ktviy/SafeRoute_Smart_Cane/README.md

<div align="center">

# SafeRoute Smart Cane

**A clip-on pod that gives a standard white cane a one-step warning for drop-offs and head-level obstacles, delivered as haptic rhythm.**







[**Live Dashboard**](https://ktviy.github.io/SafeRoute_Smart_Cane/dashboard/) ·
[**Data Report (PDF)**](docs/SafeRoute_DATA_REPORT.pdf) ·
[**Schematic**](hardware/schematic.svg) ·
[**CAD Design**](CAD_Design) ·
[**Firmware Guide**](firmware/README.md) ·
[**Experiment Results**](experiment_data/results/report.md)

</div>

<details>
<summary><b>Table of Contents</b></summary>

1. [About the Project](#about-the-project)
2. [Key Results](#key-results)
3. [How It Works](#how-it-works)
4. [Hardware](#hardware)
5. [Getting Started](#getting-started)
6. [Usage](#usage)
7. [Experiment Data](#experiment-data)
8. [Repository Structure](#repository-structure)
9. [Roadmap](#roadmap)
10. [Team](#team)
11. [Acknowledgments](#acknowledgments)
12. [License](#license)

</details>

---

## About the Project

A white cane is excellent at reading what is directly under its tip, but it misses two kinds of hazard that matter for low-vision travellers:

| Hazard | Examples | Why the cane misses it |
| --- | --- | --- |
| **Drop-offs** | Curbs, stair tops, platform edges | The tip finds the edge at nearly the same moment the user reaches it, leaving little time to react. |
| **Head-level obstacles** | Signs, branches, open truck doors | The cane sweeps the ground and passes underneath them. |

**SafeRoute** is a small pod that clips onto an existing cane. Two time-of-flight beams look ahead of the tip and up to head height. When a real hazard appears, two vibration motors send a distinct rhythm up the shaft to the hand. A three-rule filter keeps the pod **silent during normal sweeping**, so every buzz means something.

**Design principles**

- **Augment, don't replace.** The user keeps their cane and their training; the pod only adds information.
- **Alert only on hazards.** Constant feedback causes fatigue and gets ignored. The pod stays quiet unless a confirmed hazard is inside the walking corridor.
- **Every number from real data.** All thresholds and mounting angles come from 18 recordings of a real cane user. Nothing in this repository is simulated.

<p align="right">(<a href="#readme-top">back to top</a>)</p>

## Key Results

Measured on real cane recordings (walker P1, 30 Oct – 3 Nov 2026). Full method and data in the [DATA REPORT](docs/SafeRoute_DATA_REPORT.pdf).

| Metric | Result |
| --- | --- |
| Look-ahead past the cane tip | **~0.76 m** |
| Warning time at walking speed (0.78–0.84 m/s) | **0.79–0.86 s** |
| Frames a 30 cm drop stays in the beam (fastest sweep) | **3.9 frames** at 30 Hz, so 3-frame confirmation **passes** |
| Firmware angle error while walking (p95) | **2.4–3.4°** (≈ 1 cm drop-height error per degree; alert threshold is 8 cm) |
| Cane angle while walking | 41.1° (36.5–45.1°) on 120 cm cane → **36.9°** on the 130 cm build |
| Sweep frequency / half-width (p95) | 0.45–0.49 Hz / 23–24° |
| Cane angle after finding an edge | 63–84° peak, past 57° within 0.6–0.9 s |
| Stair descent rhythm | 1.47 s per step |

<p align="right">(<a href="#readme-top">back to top</a>)</p>

## How It Works

```mermaid
flowchart LR
    A["Ground ToF<br/>(19° above shaft)"] --> D["Drop height dh"]
    B["Forward ToF<br/>(73° above shaft)"] --> E["Obstacle height H"]
    C["MPU-6050 IMU"] --> F["Cane angle +<br/>sweep position"]
    F --> D
    F --> E
    D --> G{"3-rule filter<br/>confirm · band · corridor"}
    E --> G
    G -->|"drop-off"| H["3 fast strong pulses<br/>both motors"]
    G -->|"head level"| I["2 medium pulses<br/>on that side"]
    G -->|"normal sweep"| J["Silent"]
```

1. **Sensing.** The **ground beam** hits the floor about 0.76 m past the tip. Combined with the cane angle, it gives the floor height ahead (`dh`); a drop deeper than **8 cm** is a drop-off. The **forward beam** measures how high an obstacle in front is.
2. **Sweep tracking.** The MPU-6050 IMU gives the cane angle and the position within the sweep. The user holds a trained **38°** angle and sweeps **±23°**, both taken from the recordings.
3. **Filtering.** An alert must pass three rules:
   - **Confirmation:** seen in 3 consecutive frames (2 for head level).
   - **Height band:** the measured height falls in the hazard's band.
   - **Corridor:** the hazard is in the walking path, not beside it.

   When the cane is lifted above **52°** (the user has already found the edge), the pod goes quiet.
4. **Haptics.** Each hazard has its own rhythm, so the user can tell them apart without thinking.

The decision logic is plain, hardware-free C++ in [`firmware/lib/saferoute`](firmware/lib/saferoute), so it runs and is unit-tested on a laptop. The equations are in the [firmware guide](firmware/README.md#how-the-logic-works).

<p align="right">(<a href="#readme-top">back to top</a>)</p>

## Hardware

| Component | Role |
| --- | --- |
| ESP32-DevKitC | Controller, USB and BLE telemetry |
| 2 × VL53L1X time-of-flight sensors | Ground beam (19°, drop-offs) and forward beam (73°, head level) |
| MPU-6050 6-axis IMU | Cane angle and sweep position |
| 2 × DRV2605L + ERM motor discs | Left / right haptic rhythm |
| RGB LED, push button, USB power bank | Status, on / off, 5 V supply |

<p align="center">
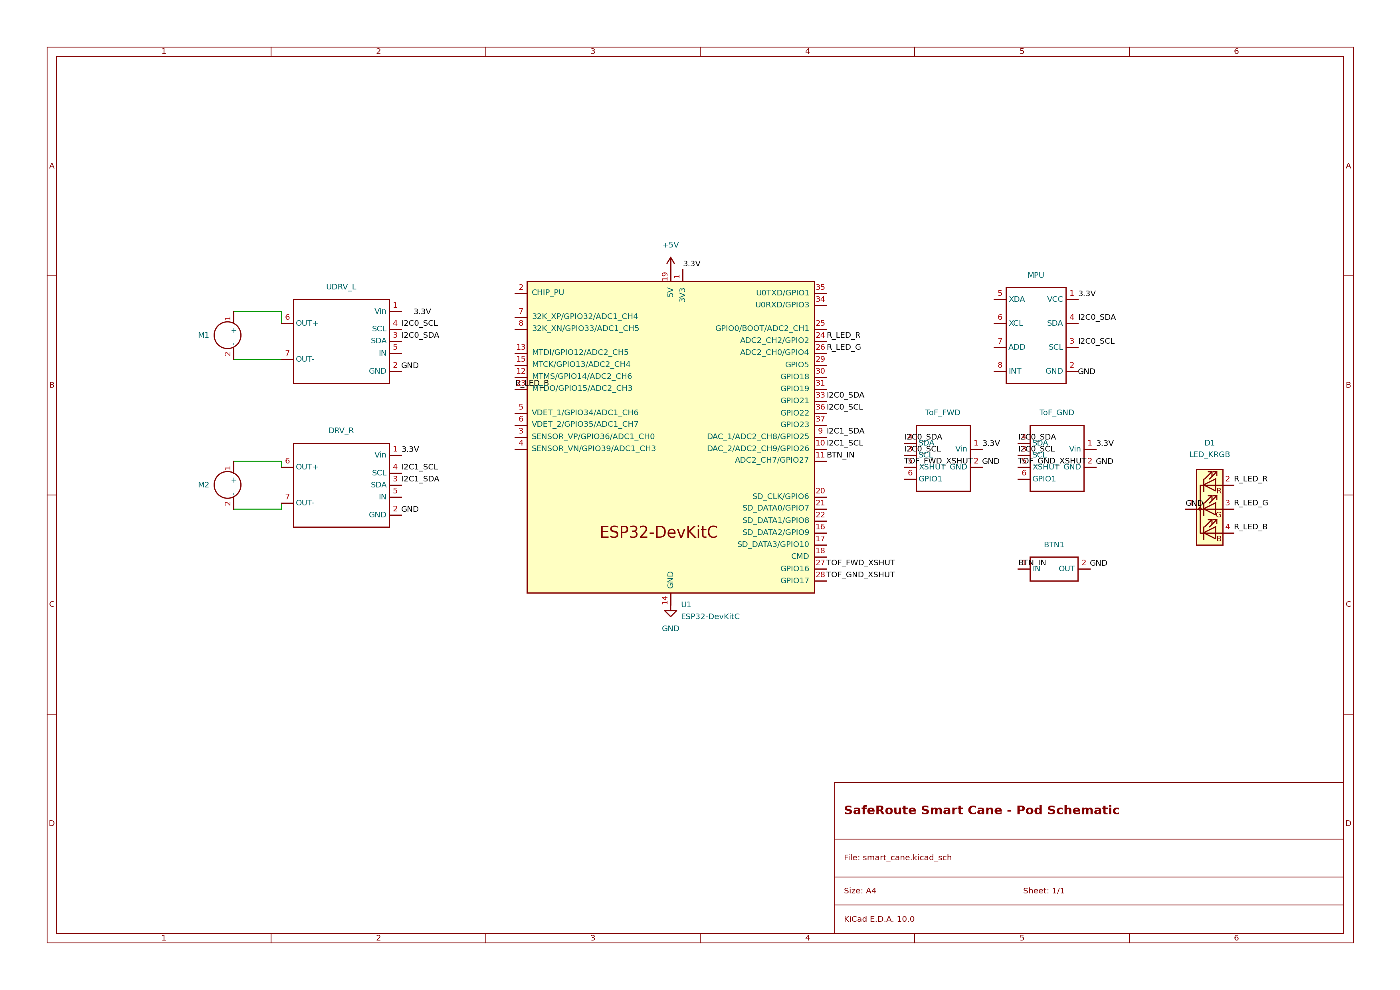
[picture p1: hardware/schematic.png]
SafeRoute schematic
  
</p>

**→ [`hardware/`](hardware):** full BOM with references, pin map, design notes and the KiCad project.

### Mechanical Design

The 130 cm cane is printed in six segments that join with spigot-and-socket fittings, and the pod attaches with a printed clip 0.72 m from the tip.

<p align="center">
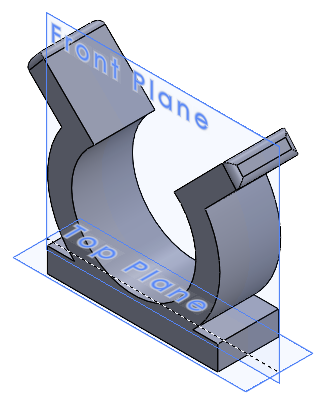
[picture p2: CAD_Design/images/HackathonClipping.png]
  
  &nbsp;&nbsp;
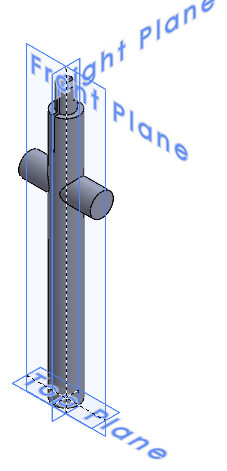
[picture p3: CAD_Design/images/HackathonStaff4.png]
  
  &nbsp;&nbsp;
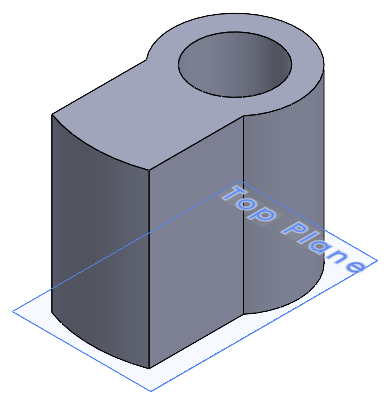
[picture p4: CAD_Design/images/UnbalancedMass.png]
  
</p>

**→ [`CAD_Design/`](CAD_Design):** SolidWorks parts, assembly order and print notes.

<p align="right">(<a href="#readme-top">back to top</a>)</p>

## Getting Started

### Prerequisites

- [PlatformIO](https://platformio.org/) (VS Code extension or `pip install platformio`)
- `gcc` on your PATH for the native unit tests
- Python 3.9+ for the experiment analysis
- Chrome or Edge for the web dashboard (Web Serial / Web Bluetooth)

### Build and Flash the Firmware

```bash
git clone https://github.com/ktviy/SafeRoute_Smart_Cane.git
cd SafeRoute_Smart_Cane/firmware

pio test -e native              # run the 45 unit tests on your laptop
pio run -e esp32dev -t upload   # build and flash the pod
pio device monitor              # 460800 baud, type 'help'
```

> [!TIP]
> On Windows, run `pio` from PowerShell. If upload hangs at `Connecting...`, hold **BOOT**, tap **EN**, and release BOOT when writing starts. More fixes are in the [troubleshooting table](firmware/README.md#build-flash-test).

### Reproduce the Analysis

```bash
cd experiment_data
pip install numpy pandas matplotlib
python analyze_cane.py analyze  # rebuilds results/ and results/plots/
```

<p align="right">(<a href="#readme-top">back to top</a>)</p>

## Usage

### Controls

| Action | Result |
| --- | --- |
| Power on | Pod starts **OFF** (lasers held off, low current) |
| **Click** | Pod turns **ON**: lasers start, one left-then-right ring, LED on |
| **Double click** | Pod turns **OFF** |

### Haptic Language

| Pattern | Meaning |
| --- | --- |
| 3 fast strong pulses, both motors | Drop-off ahead |
| 4 rapid strong pulses | Drop-off ahead, little time left |
| 2 medium pulses on one side | Head-level obstacle on that side |

Status and fault patterns are listed in the [firmware guide](firmware/README.md#using-the-pod).

### Live Dashboard

Open the [**live dashboard**](https://ktviy.github.io/SafeRoute_Smart_Cane/dashboard/) in Chrome or Edge, power the pod, then press **USB** or **Bluetooth**. Details and the Python version: [`dashboard/`](dashboard).

<p align="right">(<a href="#readme-top">back to top</a>)</p>

## Experiment Data

Every design number comes from **18 real recordings** of a white-cane user (phone IMU at 100 Hz on the cane): walking with constant-contact and two-point technique, curbs, stair tops, stair descents, objects beside the path and timed walks.

| Walking, constant contact | Stair top found |
| :---: | :---: |
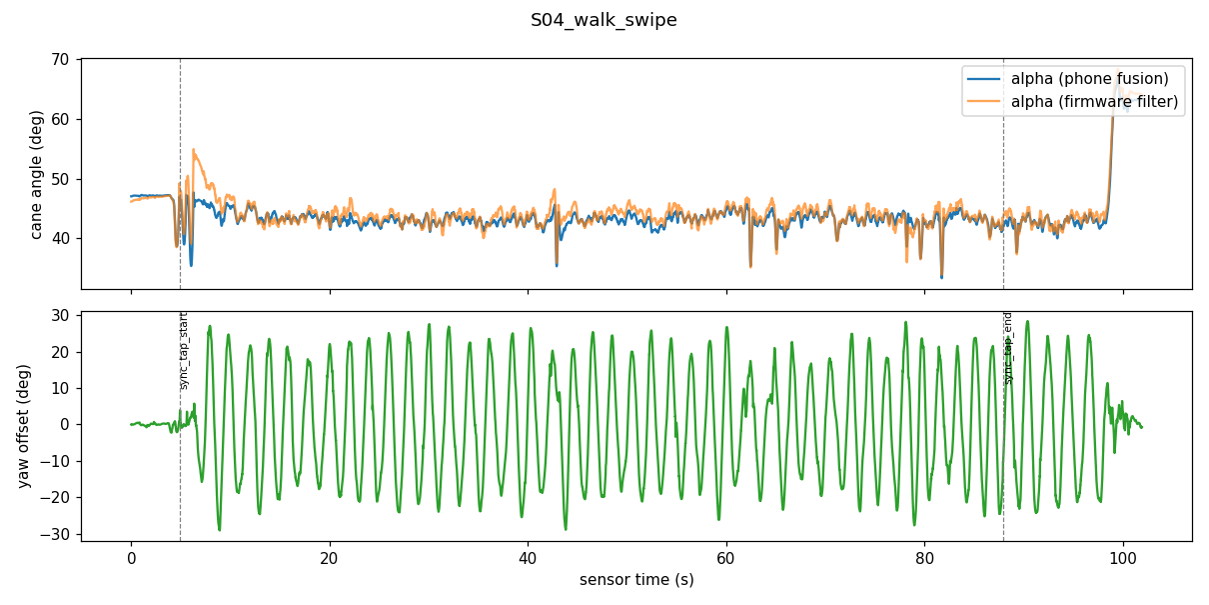
[picture p5: experiment_data/results/plots/S04_walk_swipe.png]
S04
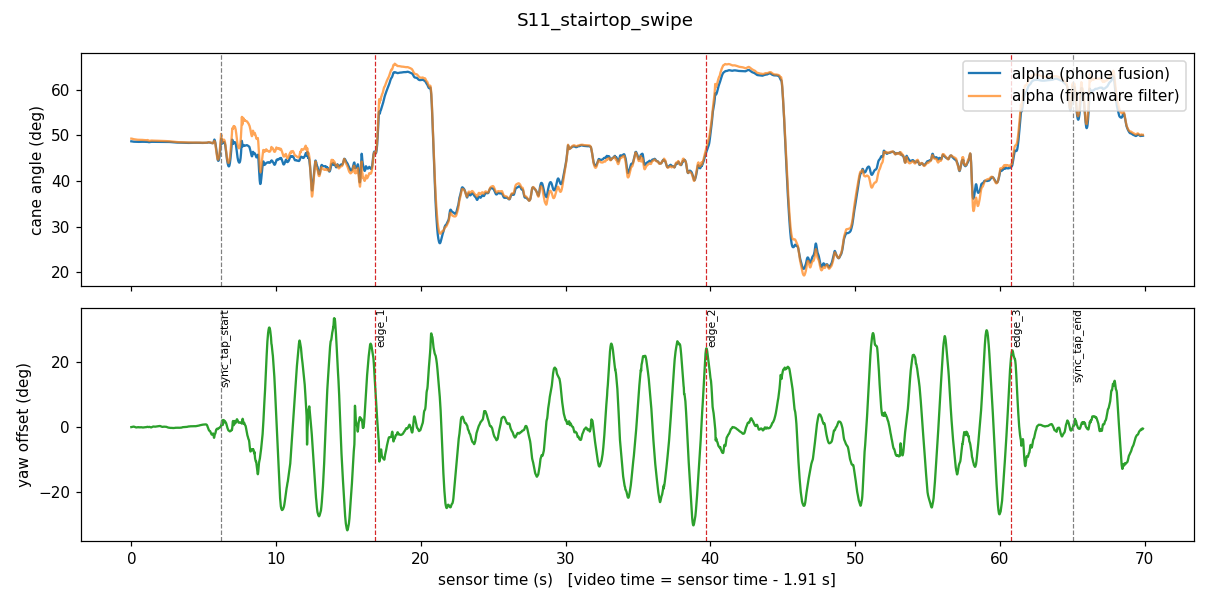
[picture p6: experiment_data/results/plots/S11_stairtop_swipe.png]
S11
|  |  |

**→ [`experiment_data/`](experiment_data):** raw data, analysis scripts, all 17 plots and the [results report](experiment_data/results/report.md).

<p align="right">(<a href="#readme-top">back to top</a>)</p>

## Repository Structure

```
SafeRoute_Smart_Cane/
├── firmware/            ESP32 firmware (PlatformIO)
│   ├── include/config.h     every tunable number and pin
│   ├── lib/saferoute/       hardware-free pod logic (kinematics, filter, haptics, ...)
│   ├── src/                 ESP32 main loop, HAL drivers, BLE telemetry
│   └── test/                45 native unit tests
├── hardware/            KiCad schematic project + SVG/PNG export
├── CAD_Design/          SolidWorks parts (cane segments, pod clip, motor mass) + preview images
├── experiment_data/     raw cane recordings, analysis scripts, results and plots
├── dashboard/           web dashboard (Web Serial / Web Bluetooth) + Python version
└── docs/                DATA REPORT: every design number and its source
```

<p align="right">(<a href="#readme-top">back to top</a>)</p>

## Roadmap

- [x] Clip-on pod with dual ToF beams and dual haptic motors
- [x] IMU-based cane angle and sweep tracking
- [x] Three-rule alert filter with edge-found pause
- [x] Live web dashboard over USB and Bluetooth
- [x] Design numbers derived from 18 real cane recordings
- [ ] Verify the cane angle statically on the 130 cm build cane
- [ ] Test with more walkers and orientation & mobility instructors
- [ ] Custom PCB and smaller enclosure

<p align="right">(<a href="#readme-top">back to top</a>)</p>

## Team

| Member | Role |
| --- | --- |
| **Vy Khong** | Electrical engineering, firmware, data analysis, dashboard |
| **Andy** | Mechanical design and CAD, beam angles, haptic test rigs |

<p align="right">(<a href="#readme-top">back to top</a>)</p>

## Acknowledgments

- Built at **MakeCU 2026**, Columbia University (Healthcare Robot track).
- [SparkFun VL53L5CX Arduino Library](https://github.com/sparkfun/SparkFun_VL53L5CX_Arduino_Library) for the ToF driver.
- [Sensor Logger](https://www.tszheichoi.com/sensorlogger) for the phone IMU recordings.
- README structure inspired by [Best-README-Template](https://github.com/othneildrew/Best-README-Template) and [SmartKnob](https://github.com/scottbez1/smartknob).

<p align="right">(<a href="#readme-top">back to top</a>)</p>

## License

No license has been chosen yet. Until one is added, all rights are reserved by the authors.

<p align="right">(<a href="#readme-top">back to top</a>)</p>
