ktviy/SafeRoute_Smart_Cane/experiment_data/results/event_metrics.csv

file | walker | scenario | event | source | sensor_time_s | video_time_s | alpha_at_event_deg | rise_to_threshold_s | alpha_peak_deg | walk_before_s | yaw_offset_at_event_deg
S03_swipe | P1 | S3 | turn_or_pause_1 | sensor | 37.79 |  | 50.9 | 0.25 | 59.3 | 34.5 | -10.9
S06_curb_stepdown_swipe | P1 | S6 | edge_1 | sensor | 18.8 | 17.18 | 46.3 | 0.35 | 60.1 | 11.6 | 4.2
S06_curb_stepdown_swipe | P1 | S6 | edge_2 | sensor | 48.56 | 46.94 | 44.6 | 1.4 | 65.0 | 11.9 | 12.4
S08_curb_stepup_tap | P1 | S8 | step_up_1 | sensor | 19.89 | 18.32 | 41.7 | 0.7 | 71.9 | 11.3 | 7.7
S08_curb_stepup_tap | P1 | S8 | step_up_2 | sensor | 51.94 | 50.37 | 42.5 | 0.98 | 61.1 | 13.3 | 1.5
S08_curb_stepup_swipe | P1 | S8 | step_up_1 | sensor | 19.67 | 17.61 | 44.8 | 0.87 | 66.8 | 12.0 | -14.0
S11_stairtop_swipe | P1 | S11 | edge_1 | sensor | 16.84 | 14.93 | 43.3 | 0.54 | 64.0 | 11.0 | 13.0
S11_stairtop_swipe | P1 | S11 | edge_2 | sensor | 39.73 | 37.82 | 43.4 | 0.54 | 64.4 | 8.5 | 24.2
S11_stairtop_swipe | P1 | S11 | edge_3 | sensor | 60.81 | 58.9 | 40.3 | 0.81 | 63.0 | 8.2 | 22.6
S12_stairtop_tap | P1 | S12 | edge_1 | sensor | 14.29 | 12.74 | 35.1 | 0.42 | 67.0 | 10.0 | -5.3
S12_stairtop_tap | P1 | S12 | edge_2 | sensor | 32.98 | 31.43 | 40.3 | 0.96 | 67.1 | 10.3 | 21.6
S12_stairtop_tap | P1 | S12 | edge_3 | sensor | 59.32 | 57.77 | 40.7 | 0.4 | 62.0 | 8.5 | -7.6
S12_stairtop_tap | P1 | S12 | probe_4 | sensor | 59.47 | 57.92 | 44.0 | 3.45 | 62.0 | 0.0 | -11.5
S13a_stair_descent | P1 | S13 | edge_1 | sensor | 16.5 | 14.86 | 43.8 | 0.76 | 83.0 | 7.7 | 1.3
S13b_stair_descent | P1 | S13 | edge_1 | sensor | 14.64 | 13.19 | 42.2 | 0.77 | 84.5 | 9.1 | 12.7
S13c_stair_descent | P1 | S13 | edge_1 | sensor | 16.39 | 14.83 | 42.7 | 0.51 | 85.6 | 14.0 | -10.1
