ktviy/SafeRoute_Smart_Cane/CAD_Design/HackathonStaff1.SLDPRT

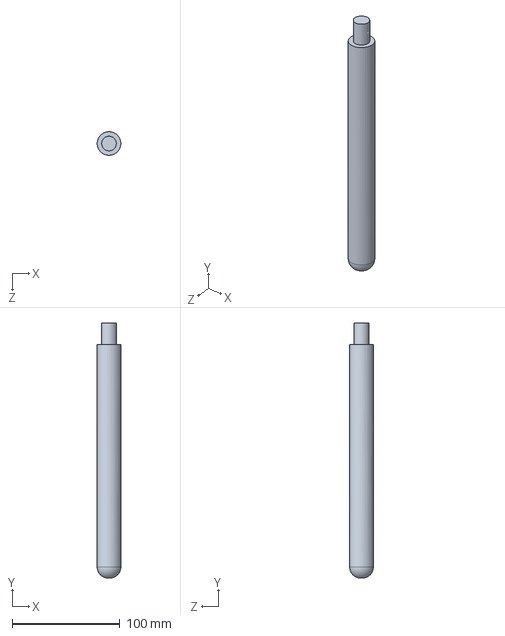
[picture p11: CAD file, 2026-11-11]
CAD_Design/HackathonStaff1.SLDPRT
22.0 x 236.5 x 22.0 mm
