ktviy/SafeRoute_Smart_Cane/CAD_Design/HackathonStaff4.SLDPRT

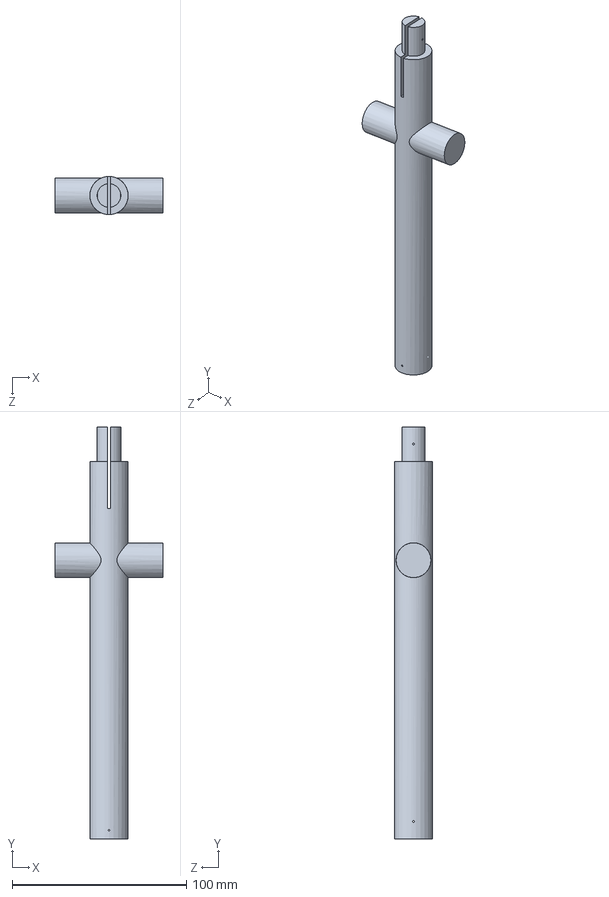
[picture p12: CAD file, 2026-11-11]
CAD_Design/HackathonStaff4.SLDPRT
62.0 x 236.5 x 22.0 mm
