ktviy/SafeRoute_Smart_Cane/CAD_Design/HackathonStaff5.SLDPRT

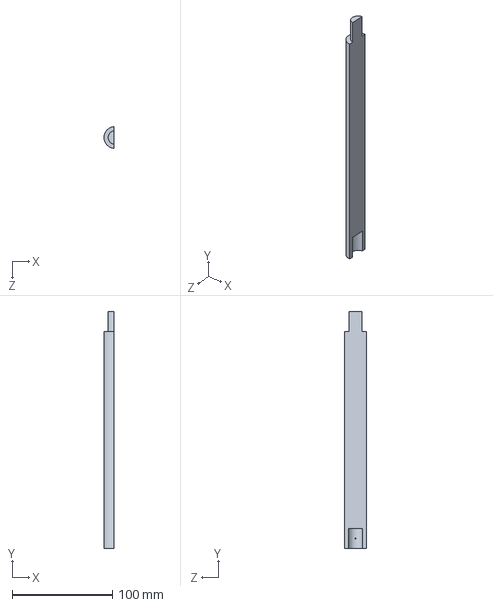
[picture p13: CAD file, 2026-11-11]
CAD_Design/HackathonStaff5.SLDPRT
10.0 x 236.5 x 21.9 mm
