ktviy/SafeRoute_Smart_Cane/CAD_Design/HackathonStaff2+3.SLDPRT

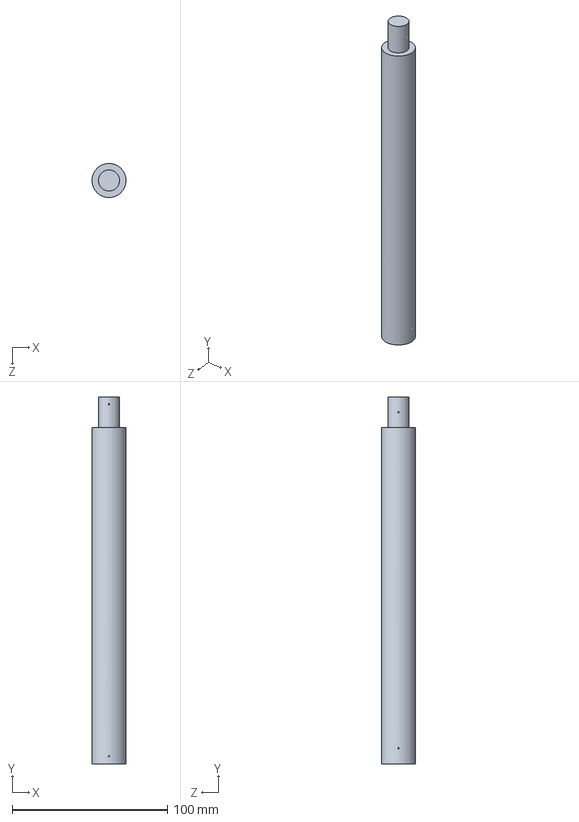
[picture p14: CAD file, 2026-11-11]
CAD_Design/HackathonStaff2+3.SLDPRT
22.0 x 236.5 x 22.0 mm
