ktviy/SafeRoute_Smart_Cane/CAD_Design/HackathonClipping.SLDPRT

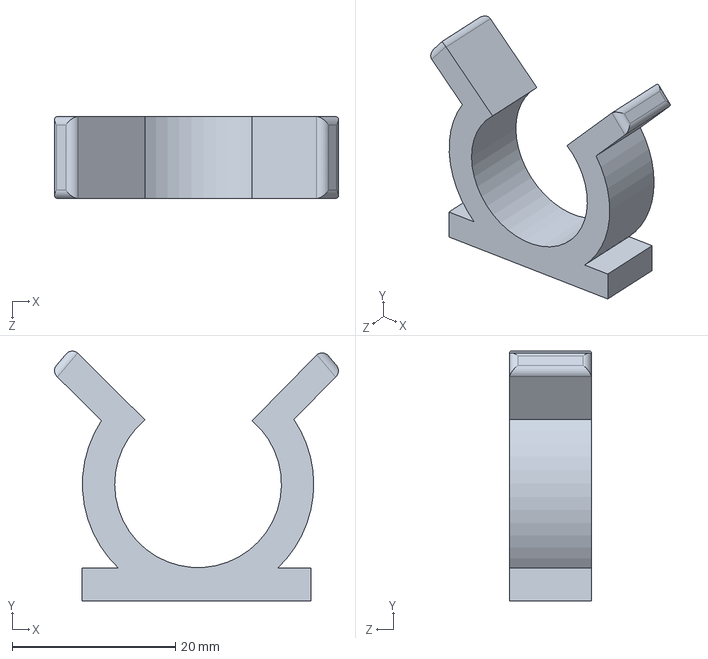
[picture p15: CAD file, 2026-11-11]
CAD_Design/HackathonClipping.SLDPRT
34.7 x 30.6 x 10.0 mm
