ktviy/SafeRoute_Smart_Cane/CAD_Design/HackathonStaff6.SLDPRT

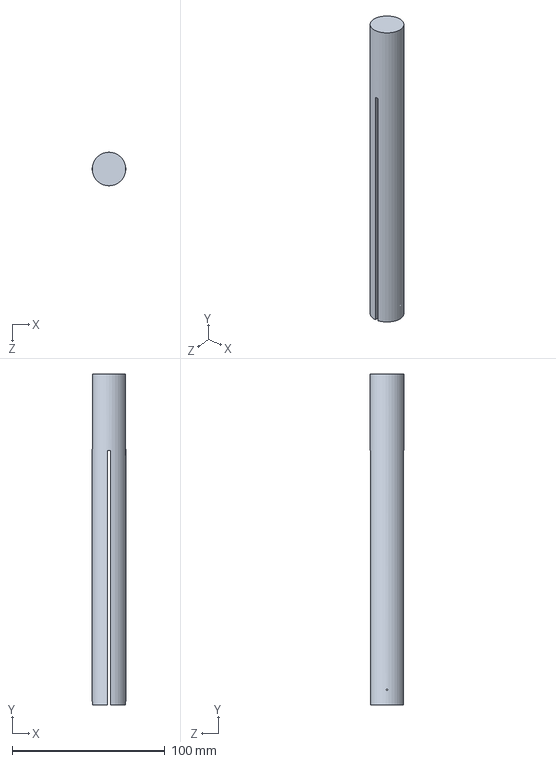
[picture p16: CAD file, 2026-11-11]
CAD_Design/HackathonStaff6.SLDPRT
22.0 x 216.7 x 22.0 mm
