ktviy/SafeRoute_Smart_Cane/CAD_Design/UnbalancedMass.SLDPRT

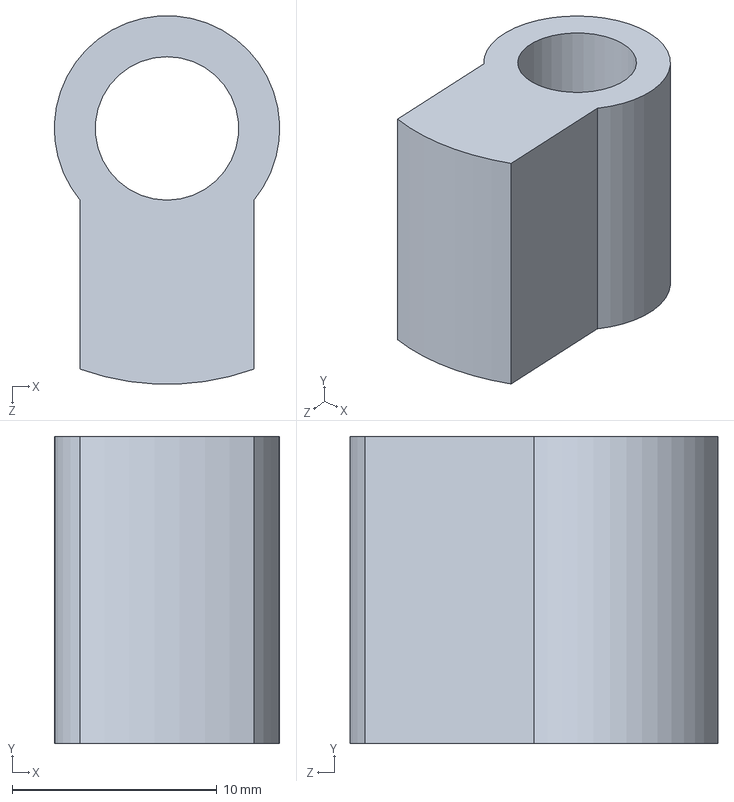
[picture p17: CAD file, 2026-11-11]
CAD_Design/UnbalancedMass.SLDPRT
11.0 x 15.0 x 18.0 mm
