ktviy/SafeRoute_Smart_Cane/experiment_data/video_sync.csv

file | video_file | offset_s | impacts_matched | impacts_in_video | sync_taps_on_clicks | match_fraction | best_other_shift | confidence | video_duration_s | sensor_duration_s | sensor_tap_start_s | video_tap_start_s | sensor_tap_end_s | video_tap_end_s
S06_curb_stepdown_swipe | S06_curb_stepdown_swipe.mp4 | 1.615 | 15 | 17 | yes | 0.88 | 0.67 | high | 52.88 | 56.14 | 6.25 | 4.64 | 52.46 | 50.84
S08_curb_stepup_tap | S08_curb_stepup_tap.mp4 | 1.575 | 31 | 31 | yes | 1.0 | 0.5 | high | 55.92 | 59.79 | 6.31 | 4.73 | 55.61 | 54.04
S08_curb_stepup_swipe | S08_curb_stepup_swipe.mp4 | 2.055 | 11 | 13 | yes | 0.85 | 0.75 | high | 50.88 | 56.22 | 5.22 | 3.17 | 51.17 | 49.12
S09_side_object_left | S09_side_object_left.mp4 | 0.48 | 16 | 18 | yes | 0.89 | 0.57 | high | 46.72 | 49.26 | 4.0 | 3.52 | 45.67 | 45.19
S09_side_object_right | S09_side_object_right.mp4 | -0.49 | 13 | 17 | yes | 0.76 | 0.61 | high | 45.91 | 49.07 | 4.33 | 4.82 | 46.12
S11_stairtop_swipe | S11_stairtop_swipe.mp4 | 1.91 | 15 | 21 | yes | 0.71 | 0.33 | high | 64.83 | 69.89 | 6.23 | 4.32 | 65.06 | 63.15
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
