ktviy/SafeRoute_Smart_Cane/experiment_data/results/summary.csv

file | walker | scenario | technique | status | duration_s | sample_rate_hz | gravity_ok | sync_tap_start_s | sync_tap_end_s | video_offset_s | video_sync | alpha_median_deg | alpha_p5_deg | alpha_p95_deg | pitch_swing_deg | alpha_static_deg | alpha_cf_static_deg | inclinometer_deg | alpha_error_deg | alpha_cf_error_deg | notes | gyro_bias_dps | alpha_flat_deg | alpha_basic_err_p95_deg | alpha_fw_err_p95_deg | alpha_fw_corr_err_p95_deg | sweep_width_deg | sweep_freq_hz | sweep_halfwidth_p95_deg | yaw_rate_p90_dps | frames_in_view_typical | frames_in_view_worst | cadence_spm | alpha_walk_max_deg | tap_cycles | tap_lift_median_cm | tap_lift_p90_cm | edges_found | walk_speed_stopwatch_mps | walk_speed_runs_mps | walk_speed_mps | stair_impacts | seconds_per_step | descent_s
S01_natural_angle | P1 | S1 | static | ok | 10.7 | 100.1 | True |  |  |  |  | 45.8 | 45.7 | 46.1 | 0.4 | 45.8 | 45.82 | 43.53 | 2.27 | 2.29 | iPhone export: accel (g) + gravity combined
S01_high_angle | P1 | S1 | static | ok | 11.7 | 100.1 | True |  |  |  |  | 61.0 | 60.8 | 61.1 | 0.3 | 60.98 | 61.05 | 59.45 | 1.53 | 1.6 | iPhone export: accel (g) + gravity combined
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
