ktviy/SafeRoute_Smart_Cane/experiment_data/results/plots/S01_natural_angle.png

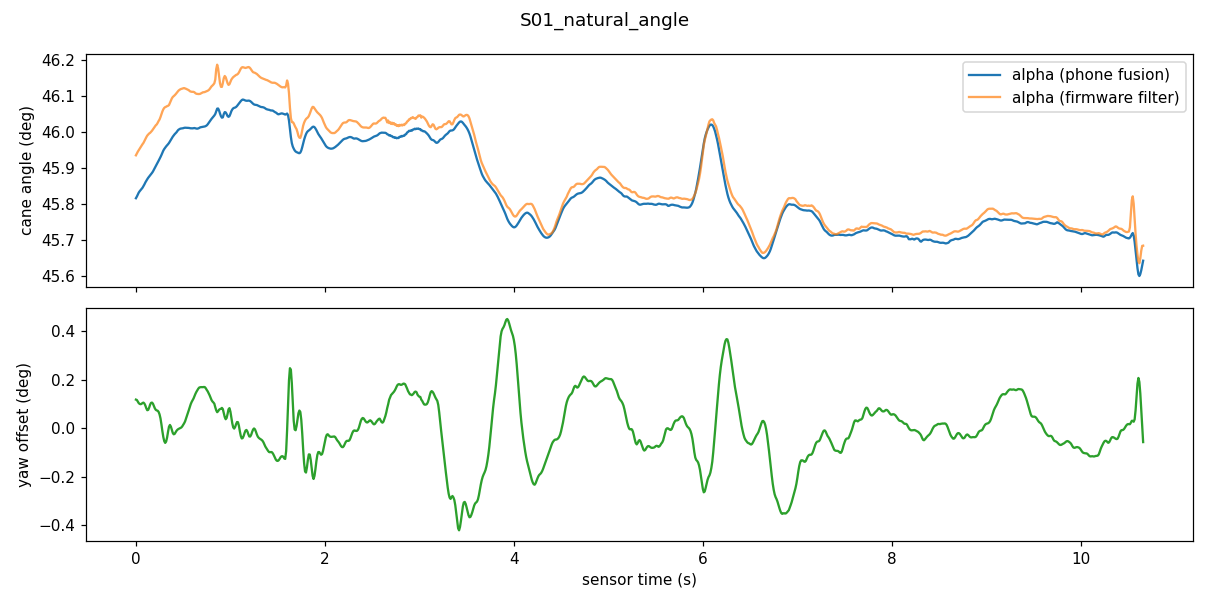
experiment_data/results/plots/S01_natural_angle.png
