ktviy/SafeRoute_Smart_Cane/experiment_data/results/plots/S02_gyro.png

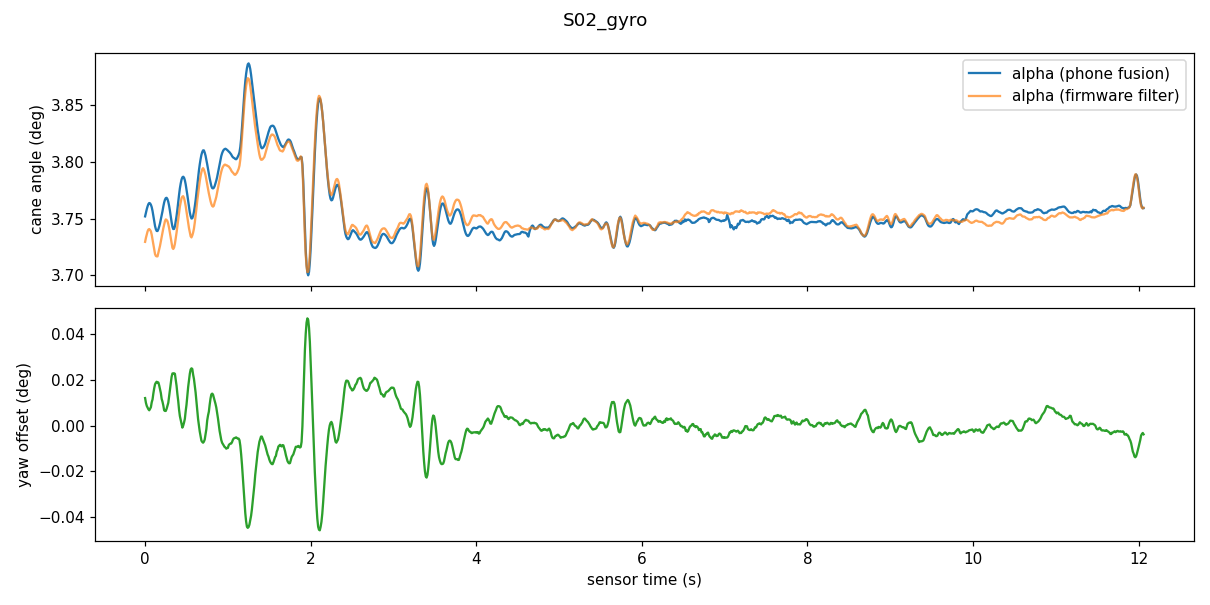
experiment_data/results/plots/S02_gyro.png
