ktviy/SafeRoute_Smart_Cane/experiment_data/results/plots/S03_swipe.png

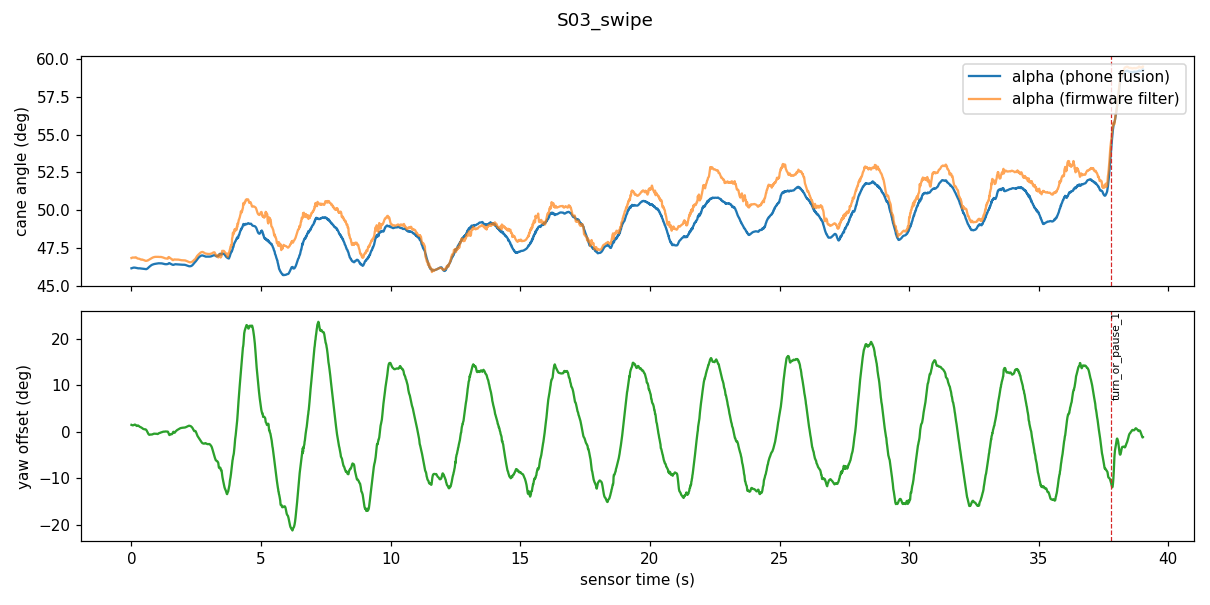
experiment_data/results/plots/S03_swipe.png
