ktviy/SafeRoute_Smart_Cane/experiment_data/results/plots/S08_curb_stepup_tap.png

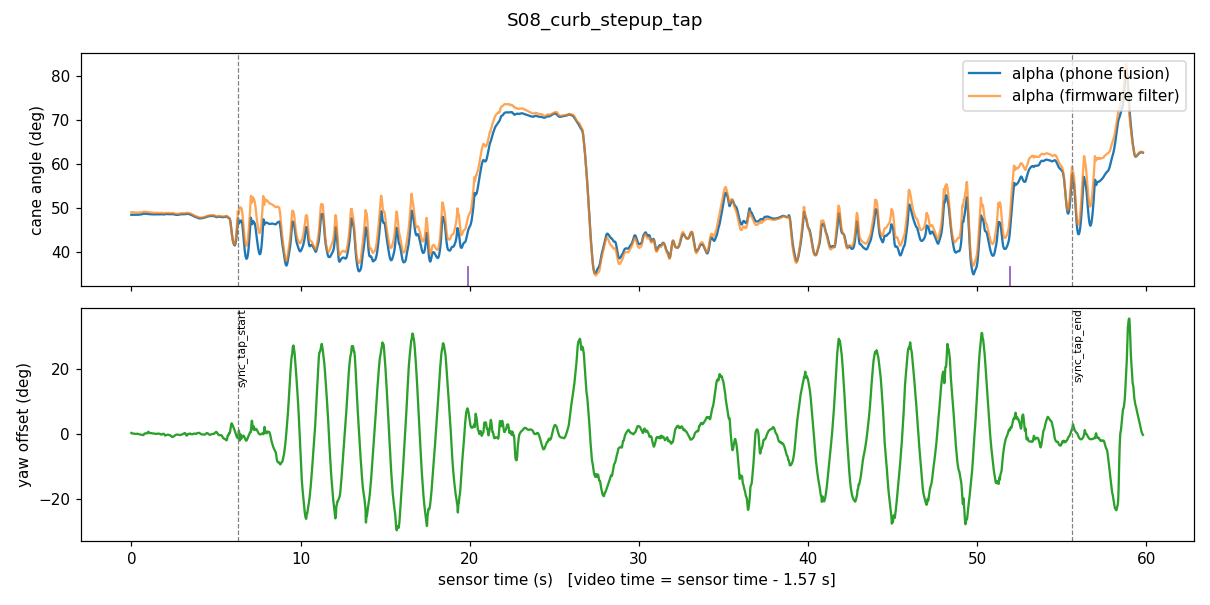
experiment_data/results/plots/S08_curb_stepup_tap.png
