ktviy/SafeRoute_Smart_Cane/experiment_data/results/plots/S09_side_object_right.png

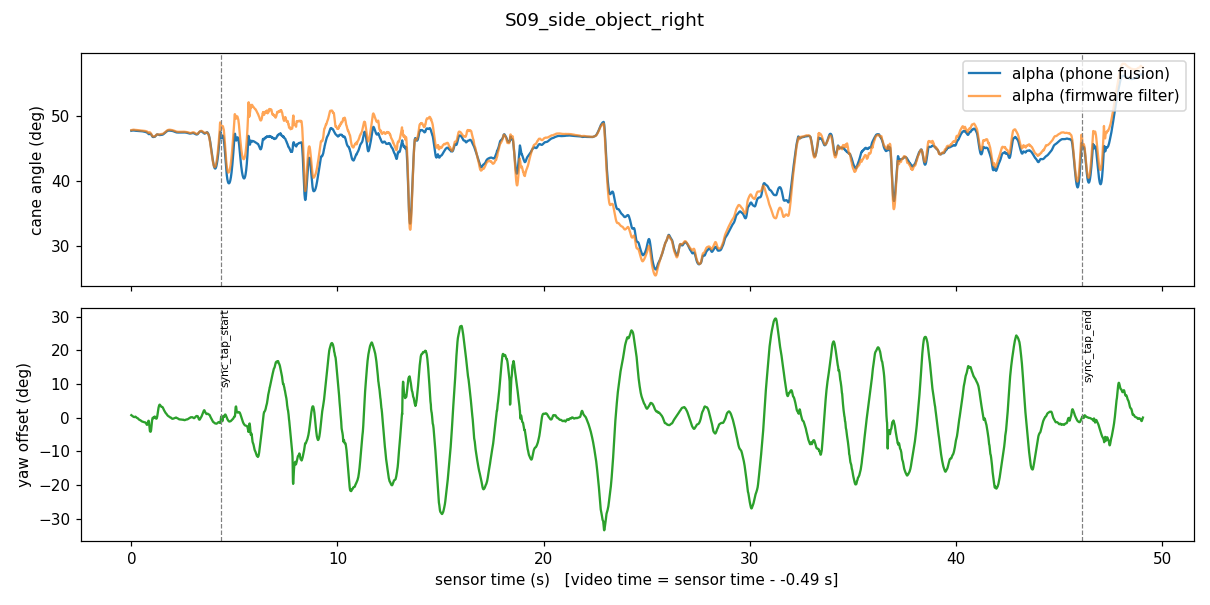
experiment_data/results/plots/S09_side_object_right.png
