ktviy/SafeRoute_Smart_Cane/experiment_data/results/plots/S12_stairtop_tap.png

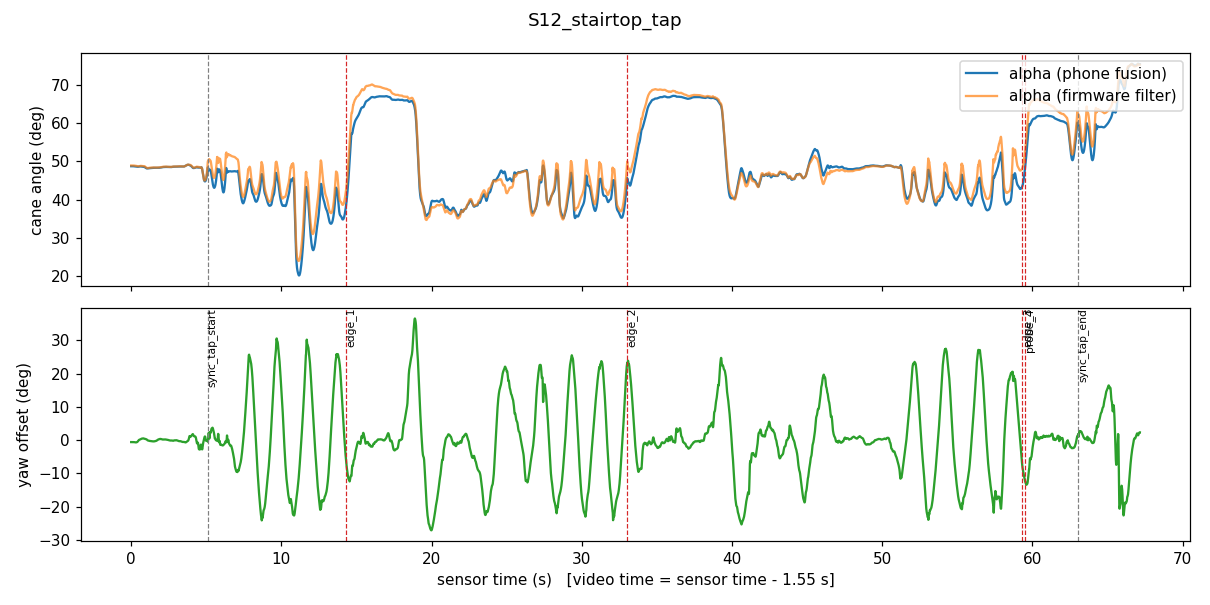
experiment_data/results/plots/S12_stairtop_tap.png
