ktviy/SafeRoute_Smart_Cane/experiment_data/results/plots/S13a_stair_descent.png

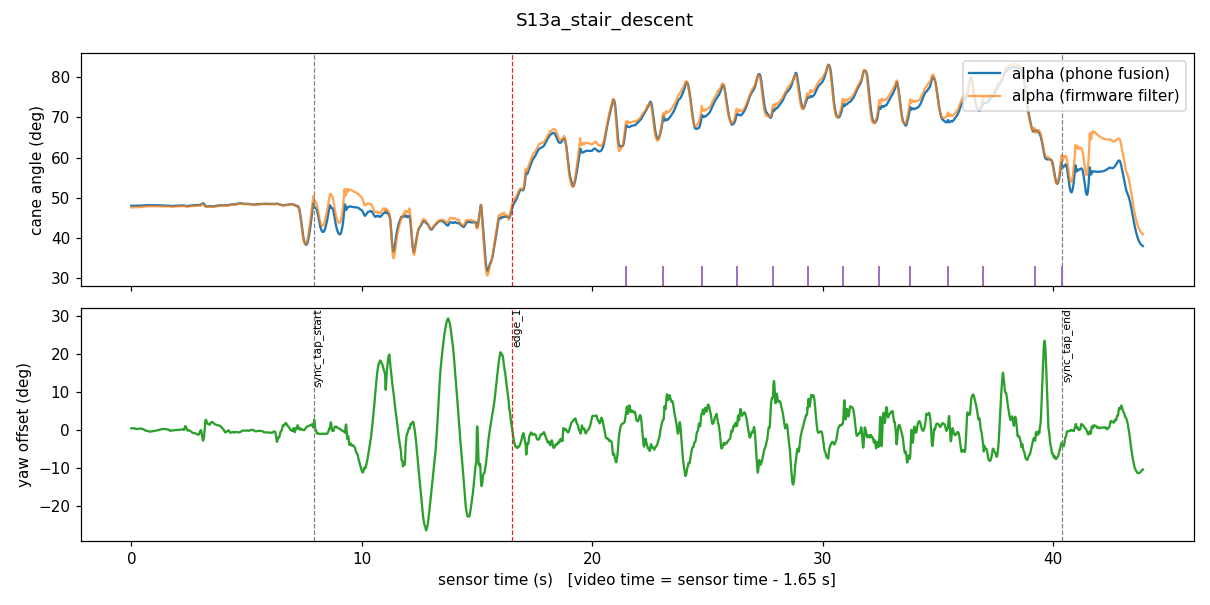
experiment_data/results/plots/S13a_stair_descent.png
