ktviy/SafeRoute_Smart_Cane/experiment_data/results/plots/S13b_stair_descent.png

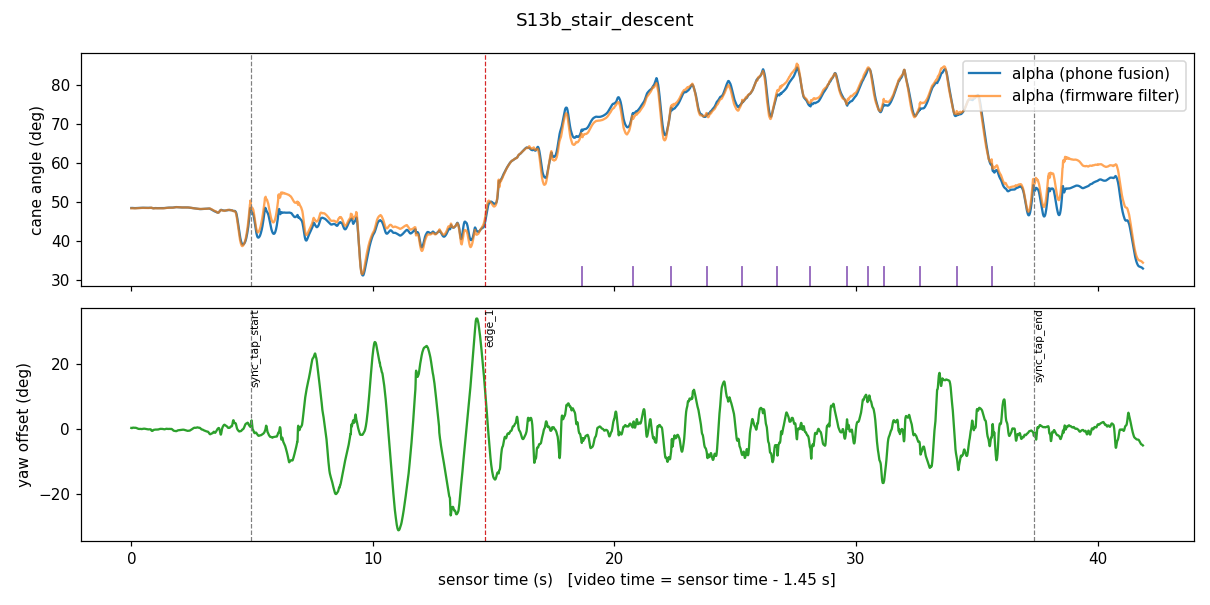
experiment_data/results/plots/S13b_stair_descent.png
