ktviy/SafeRoute_Smart_Cane/experiment_data/results/plots/S15_stairtop_parallel.png

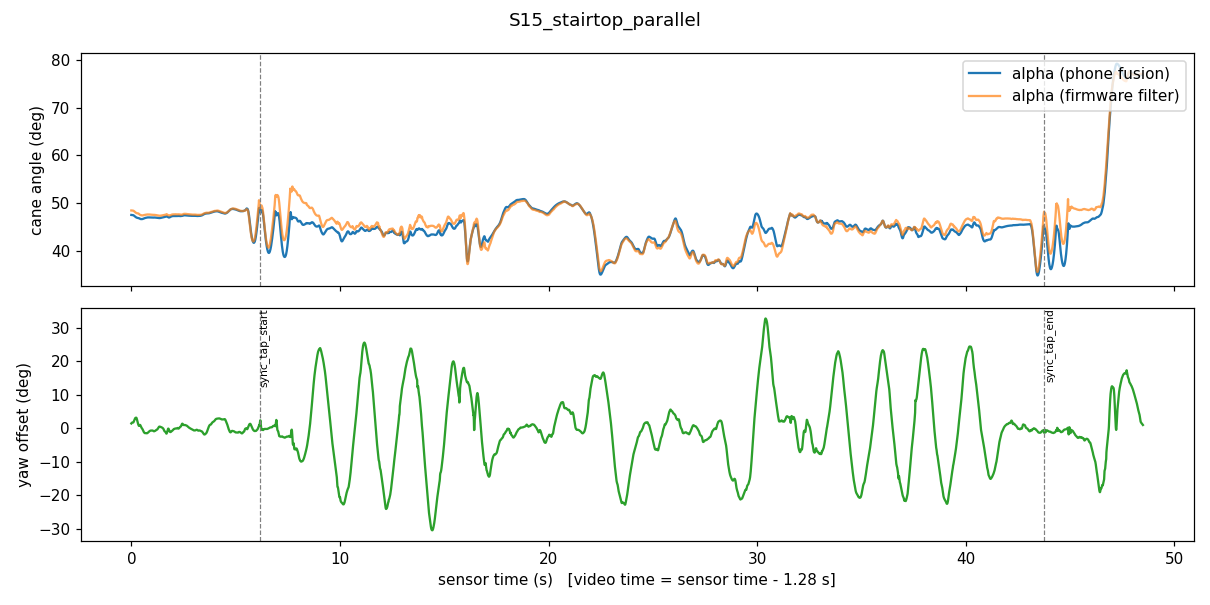
experiment_data/results/plots/S15_stairtop_parallel.png
