ktviy/SafeRoute_Smart_Cane/hardware/kicad/smart_cane.kicad_sch

## KiCad design hardware/kicad/smart_cane.kicad_sch (2026-11-08)

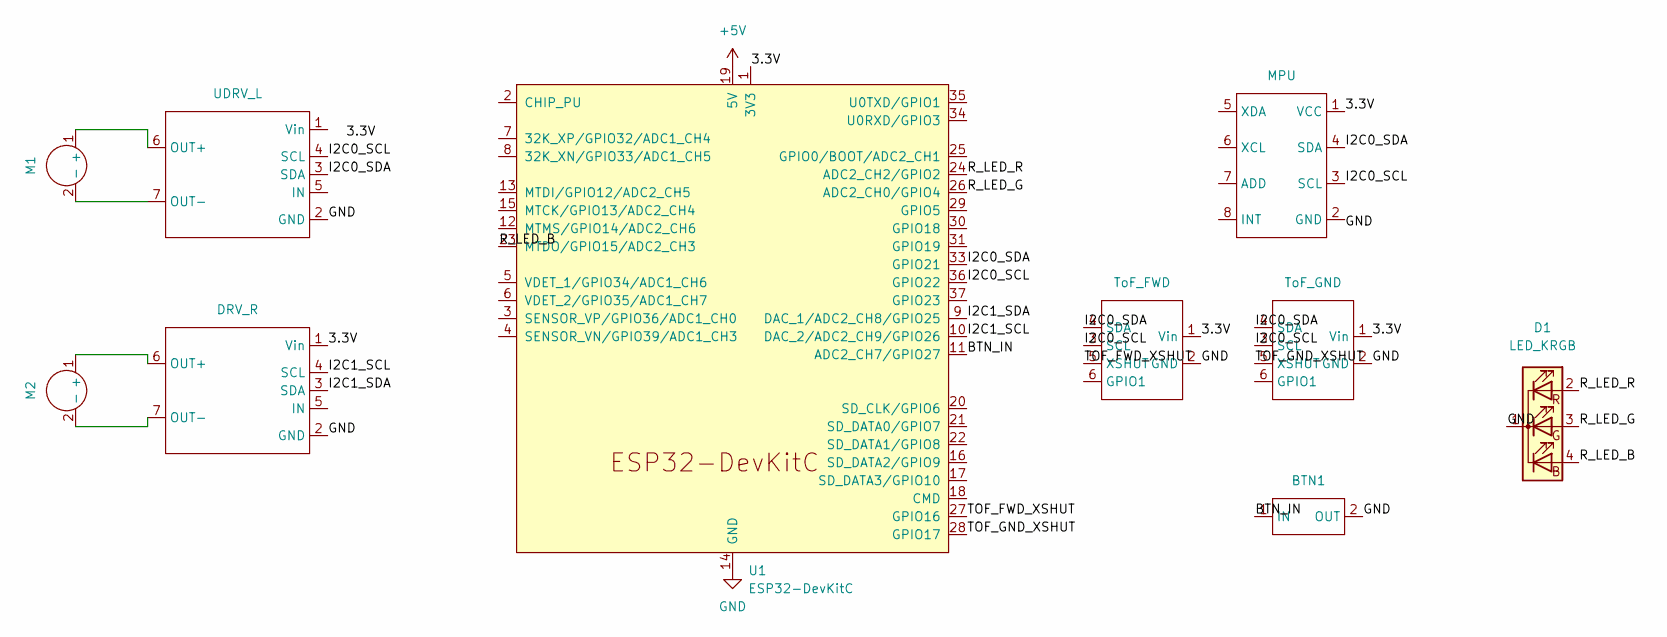
[picture p33: schematic smart_cane.kicad_sch]

Parts:
BTN1: (no value)
D1: LED_KRGB
DRV_R: (no value)
M1, M2: (no value)
MPU: (no value)
ToF_FWD: (no value)
ToF_GND: (no value)
U1: ESP32-DevKitC
UDRV_L: (no value)

Connections:
3.3V: DRV_R.1 (Vin), MPU.1 (VCC), ToF_FWD.1 (Vin), ToF_GND.1 (Vin), U1.1 (3V3)
+5V: U1.19 (5V)
BTN_IN: BTN1.1 (IN), U1.11 (ADC2_CH7/GPIO27)
GND: BTN1.2 (OUT), D1.1 (K), DRV_R.2 (GND), ToF_FWD.2 (GND), ToF_GND.2 (GND), U1.14 (GND), U1.32 (GND), U1.38 (GND), UDRV_L.2 (GND)
I2C0_SCL: MPU.3 (SCL), ToF_FWD.3 (SCL), ToF_GND.3 (SCL), U1.36 (GPIO22), UDRV_L.4 (SCL)
I2C0_SDA: MPU.4 (SDA), ToF_FWD.4 (SDA), ToF_GND.4 (SDA), U1.33 (GPIO21), UDRV_L.3 (SDA)
I2C1_SCL: DRV_R.4 (SCL), U1.10 (DAC_2/ADC2_CH9/GPIO26)
I2C1_SDA: DRV_R.3 (SDA), U1.9 (DAC_1/ADC2_CH8/GPIO25)
unnamed: DRV_R.6 (OUT+), M2.1 (+)
unnamed: DRV_R.7 (OUT-), M2.2 (-)
unnamed: M1.1 (+), UDRV_L.6 (OUT+)
unnamed: M1.2 (-), UDRV_L.7 (OUT-)
R_LED_B: D1.4 (BA), U1.23 (MTDO/GPIO15/ADC2_CH3)
R_LED_G: D1.3 (GA), U1.26 (ADC2_CH0/GPIO4)
R_LED_R: D1.2 (RA), U1.24 (ADC2_CH2/GPIO2)
TOF_FWD_XSHUT: ToF_FWD.5 (XSHUT), U1.27 (GPIO16)
TOF_GND_XSHUT: ToF_GND.5 (XSHUT), U1.28 (GPIO17)
