ktviy/SafeRoute_Smart_Cane/(commit log)

2026-11-08 SafeRoute Smart Cane: firmware, schematic, experiment data, dashboard
    - firmware/: ESP32 pod firmware (PlatformIO), real sensors only.
    Button: click = ON (lasers start, ring, LED on), double click / hold = OFF.
    45 unit tests (pio test -e native).
    - hardware/: as-built schematic (SVG/PNG) + original KiCad design (not as built).
    - experiment_data/: real cane-motion recordings (walker P1), analysis
    scripts, results and plots. Videos not included (179 MB).
    - dashboard/: live web dashboard (Web Serial / Web Bluetooth) + Python version.
    - docs/: DATA REPORT.
    [approaches.csv, event_metrics.csv, events.csv, events_synced.csv, log.csv, smart_cane.kicad_sch, summary.csv, video_sync.csv]
2026-11-11 docs: rewrite README in standard project format
    Centered header with badges and quick links, table of contents,
    key results, pipeline diagram, BOM, getting started, usage,
    roadmap, team and acknowledgments.
2026-11-11 Create folder for CAD design
2026-11-11 hardware: publish full KiCad design schematic
    Replace the MakeCU as-built schematic with the full KiCad design
    (VL53L1X ToF x2, MPU-6050 IMU, DRV2605L haptic drivers x2, RGB LED).
    Rename kicad_original_plan/ to kicad/, render schematic.svg/png from
    the .kicad_sch with render_schematic.py, and update the BOM and pin
    map in the hardware and main READMEs.
    [smart_cane.kicad_sch]
2026-11-11 docs: add SolidWorks preview images for CAD parts
    Previews are the PreviewPNG thumbnails SolidWorks stores inside each
    .SLDPRT, cropped to the part.
2026-11-11 docs: move section details into folder READMEs
    Main README keeps a short summary, one image and a link per area.
    New CAD_Design/README.md (parts, assembly order, print notes) and
    dashboard/README.md; experiment_data/README.md gains the results
    table and plots.
